cypher1024/CanopyLights/circuit_diagram.png

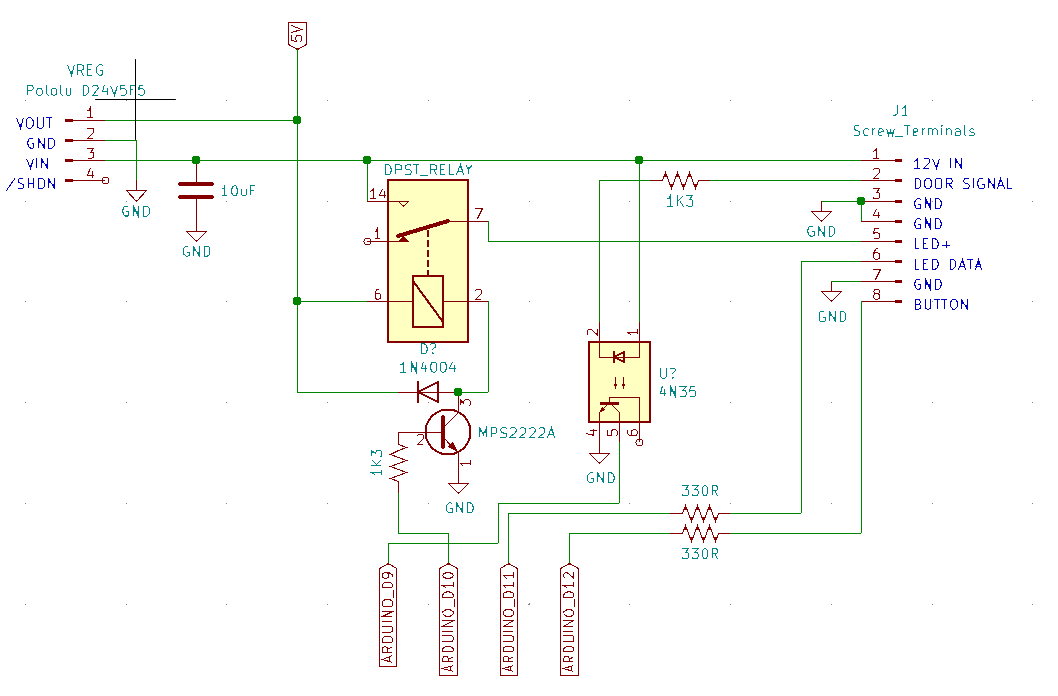
circuit_diagram.png
